g7ltt/OpenAPRS-tracker/README.md

# OpenAPRS-tracker

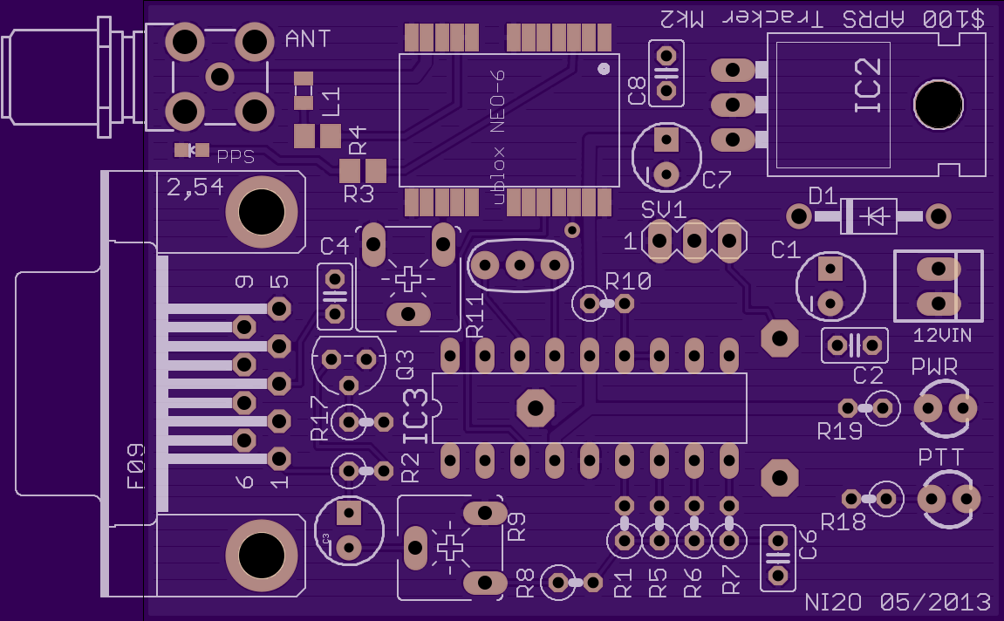
[picture p1: i.png]
opentracker
