g7ltt/OpenAPRS-tracker/AprsCirc-1a.jpg

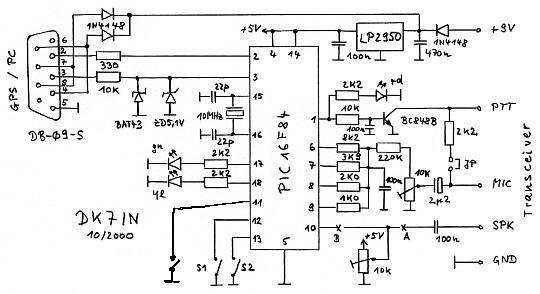
AprsCirc-1a.jpg
