g7ltt/OpenAPRS-tracker/APRSTracker_GPS.pdf

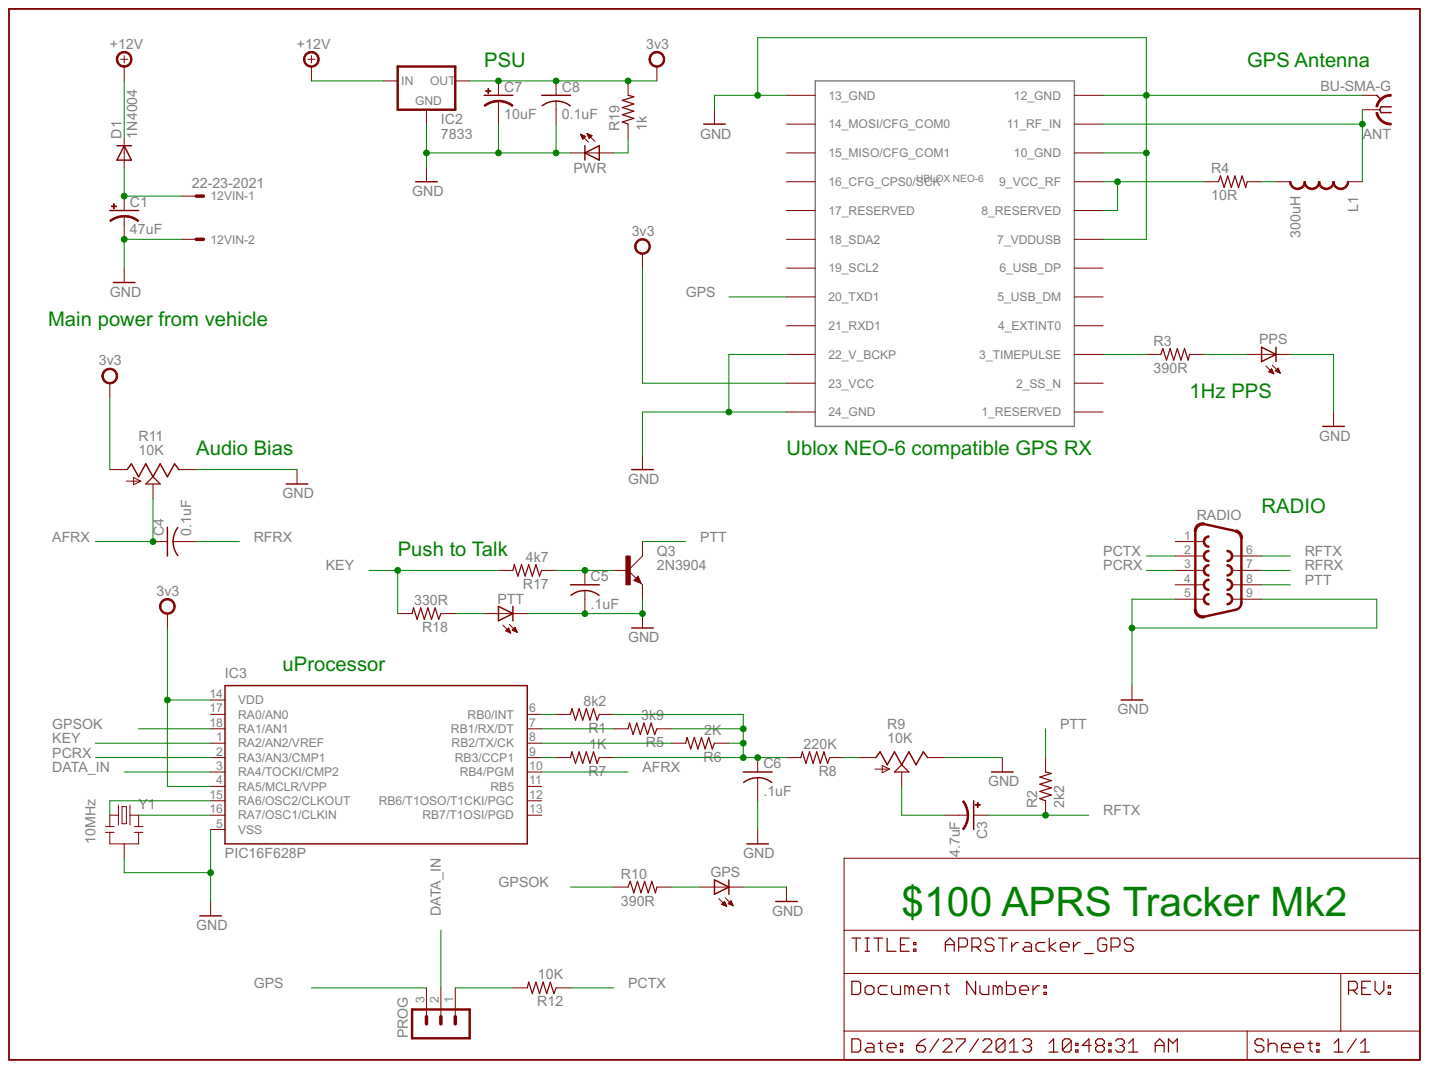
[picture p12: page 1]

Main power from vehicle

24_GND
Ublox NEO-6 compatible GPS RX
