g7ltt/OpenAPRS-tracker/APRSTracker_GPS_Mk2.pdf

Main power from vehicle

24_GND
Ublox NEO-6 compatible GPS RX
