g7ltt/OpenAPRS-tracker/OpenTracker_GPS-board.pdf

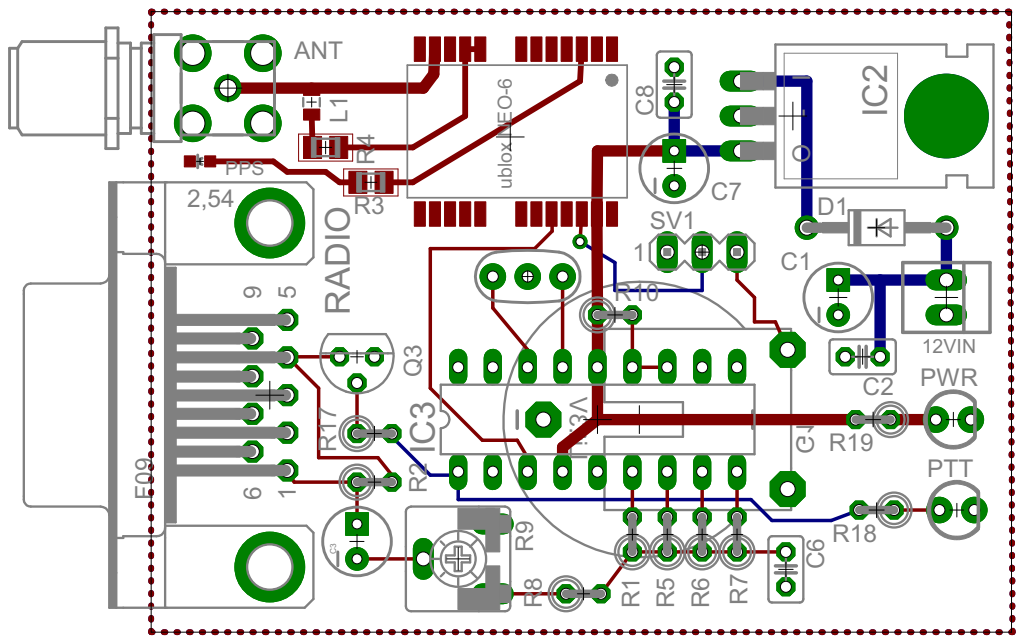
[picture p13: page 1]

G1 Lit.3V ublox NEO-6 1 95 6 2,54 F09 1 - I O ANT C2 RADIO 12VIN PPS R3 D1 R4 L1 C1 C7 C8 SV1 IC2 R2 C6 Q3 R17 R18 PTT R19 PWR IC3 R1R5R6R7 R8 R9 R10 C3
