g7ltt/OpenAPRS-tracker/OpenTracker_GPS.pdf

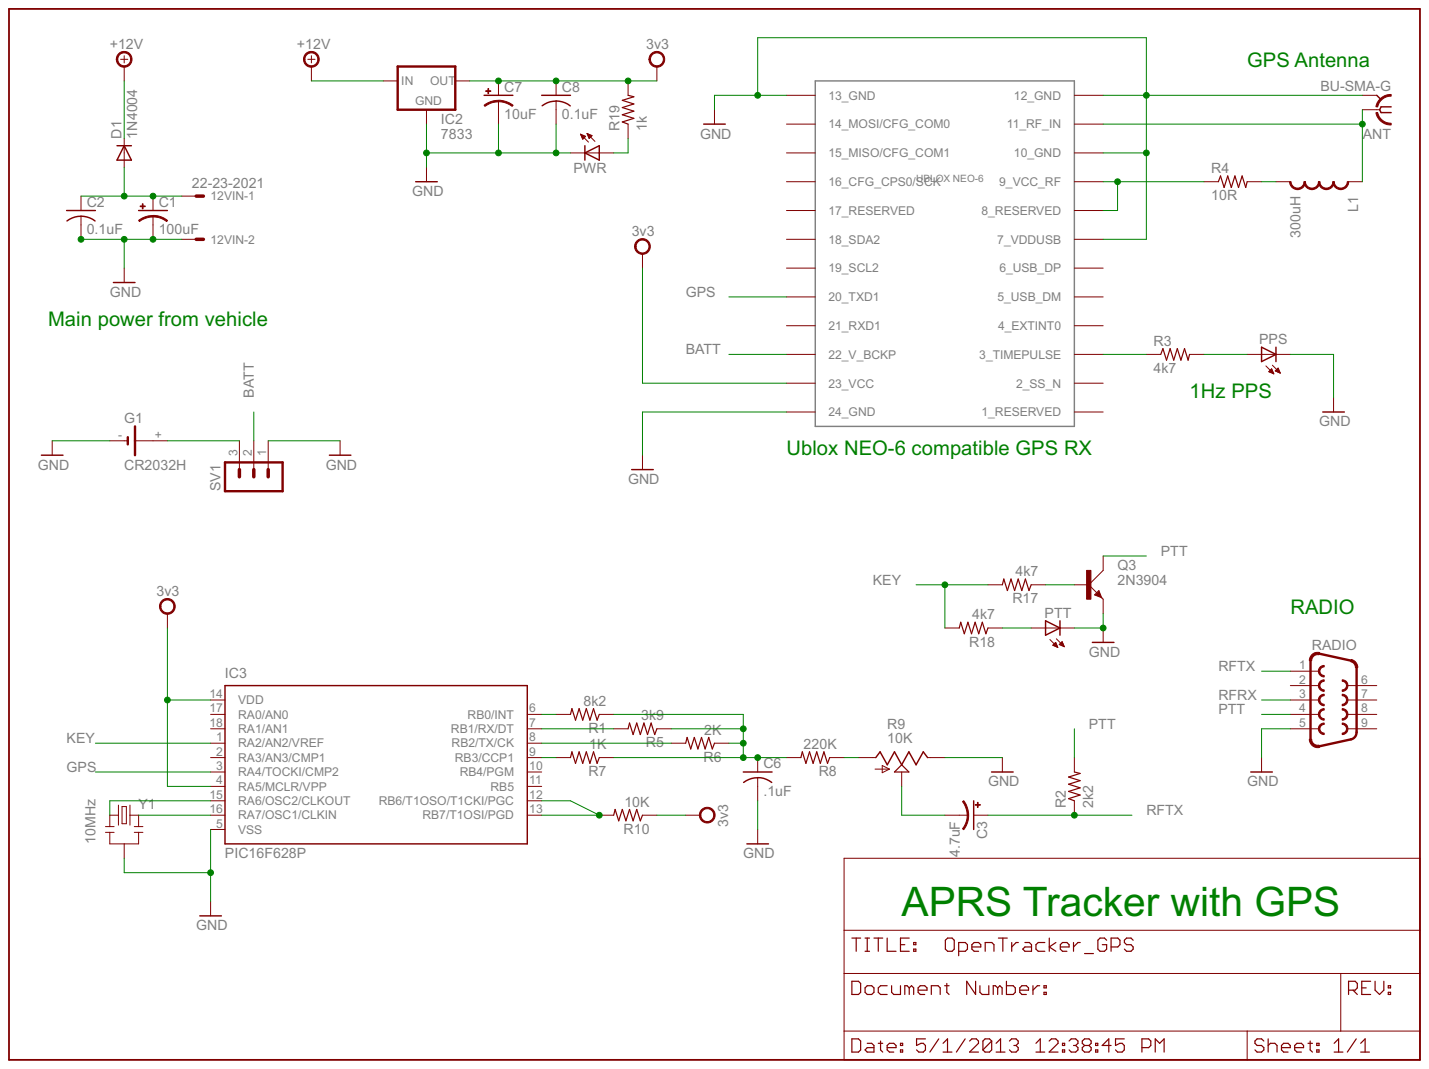
[picture p14: page 1]

Main power from vehicle

24_GND
Ublox NEO-6 compatible GPS RX

APRS Tracker with GPS
