g7ltt/OpenAPRS-tracker/APRSTracker_GPS.sch

## EAGLE design APRSTracker_GPS.sch (2021-09-01)

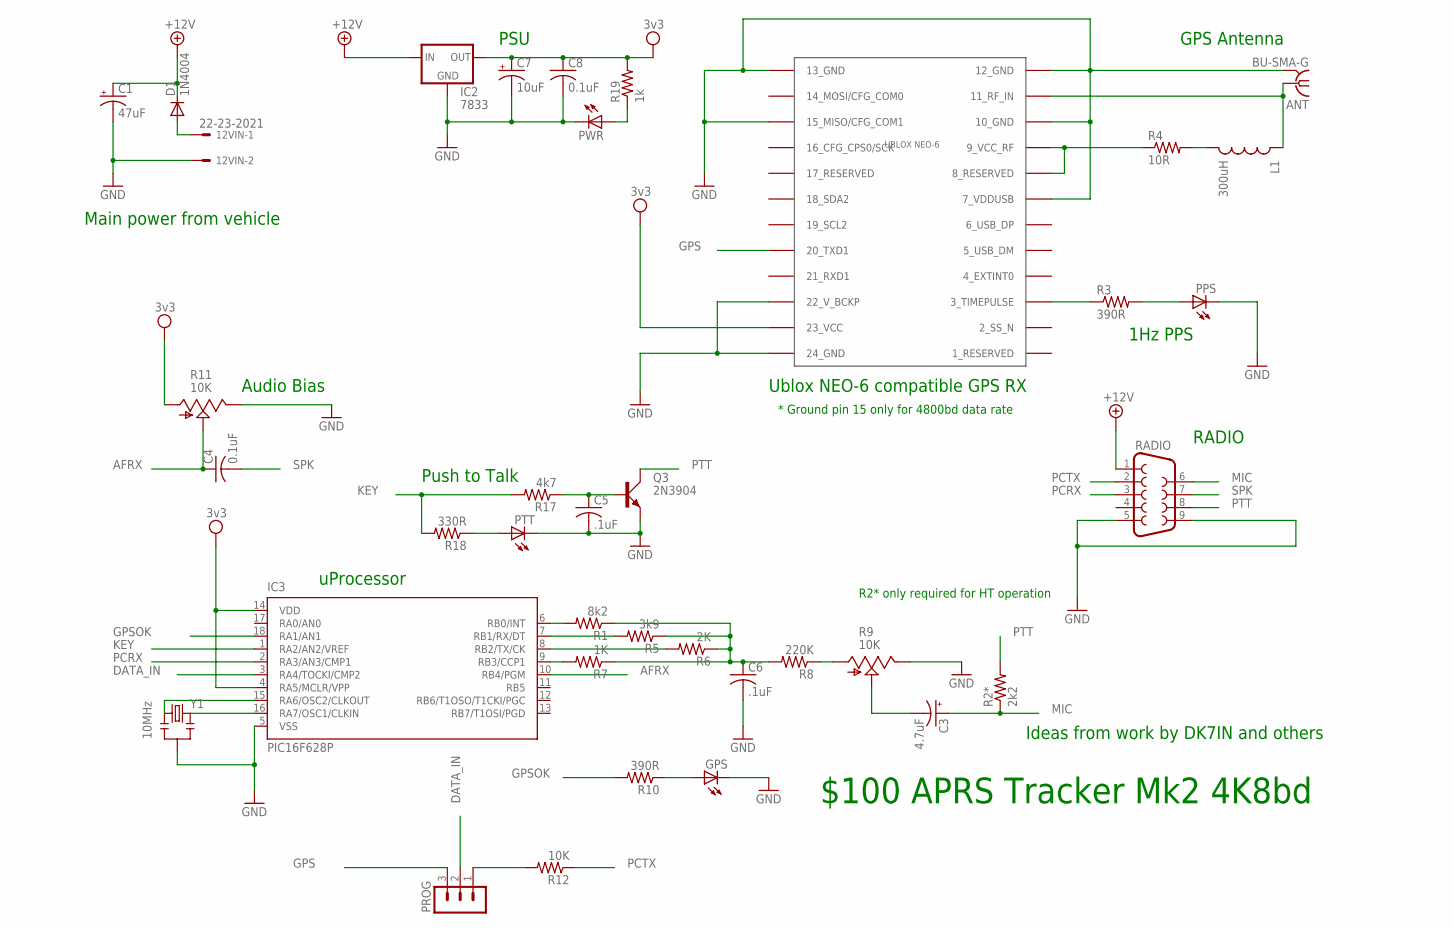
[picture p15: schematic APRSTracker_GPS.sch]

Parts:
12VIN: 22-23-2021
ANT: BU-SMA-G
C1: 47uF; CPOL-RADIAL-10UF-25V
C3: 4.7uF; CPOL-RADIAL-10UF-25V
C4, C8: 0.1uF; C025-025X050
C5, C6: .1uF; C025-025X050
C7: 10uF; CPOL-RADIAL-10UF-25V
D1: 1N4004; DO41-10
GPS: LED3MM
IC2: 7833; TO-220-ALT
IC3: PIC16F628P; DIL18
L1: 300uH; 0805
PPS: LED1206; LED-1206
PROG: MA03-1
PTT: LED3MM
PWR: LED3MM
Q3: 2N3904; TO92D
R1: 8k2; 0207/2V
R2*: 2k2; 0207/2V
R3: 390R; M0805
R4: 10R; M0805
R5: 3k9; 0207/2V
R6: 2K; 0207/2V
R7: 1K; 0207/2V
R8: 220K; 0207/2V
R9, R11: 10K; CA6V
R10: 390R; 0207/2V
R12: 10K; 0207/2V
R17: 4k7; 0207/2V
R18: 330R; 0207/2V
R19: 1k; 0207/2V
RADIO: F09HP
U$1: UBLOX_NEO-6; UBLOX_NEO-6P
Y1: 10MHz; RESONATOR-PTH

Connections:
+12V: C1.1 (+), D1.C, IC2.IN, RADIO.1
AFRX: C4.1, IC3.10 (RB4/PGM), R11.S
DATA_IN: IC3.3 (RA4/TOCKI/CMP2), PROG.2
GND: 12VIN.2, ANT.2 (GND), C1.2 (-), C5.2, C6.2, C7.2 (-), C8.2, GPS.K (C), IC2.GND, IC3.5 (VSS), PPS.C, PTT.K (C), PWR.K (C), Q3.E, R9.E, R11.E, RADIO.5, RADIO.9, U$1.7_VDDUSB, U$1.10_GND, U$1.12_GND, U$1.13_GND, U$1.15_MISO/CFG_COM1, U$1.22_V_BCKP, U$1.24_GND, Y1.2
GPS: PROG.3, U$1.20_TXD1
GPSOK: IC3.18 (RA1/AN1), R10.2
KEY: IC3.1 (RA2/AN2/VREF), R17.2, R18.2
MIC: C3.1 (+), R2*.1, RADIO.6
unnamed: R3.1, U$1.3_TIMEPULSE
unnamed: ANT.1, L1.1, U$1.11_RF_IN
unnamed: L1.2, R4.2
unnamed: R4.1, U$1.8_RESERVED, U$1.9_VCC_RF
unnamed: PPS.A, R3.2
unnamed: PWR.A, R19.1
unnamed: GPS.A, R10.1
unnamed: IC3.6 (RB0/INT), R1.2
unnamed: IC3.16 (RA7/OSC1/CLKIN), Y1.3
unnamed: IC3.15 (RA6/OSC2/CLKOUT), Y1.1
unnamed: IC3.7 (RB1/RX/DT), R5.2
unnamed: IC3.8 (RB2/TX/CK), R6.2
unnamed: IC3.9 (RB3/CCP1), R7.2
unnamed: C6.1, R1.1, R5.1, R6.1, R7.1, R8.2
unnamed: 12VIN.1, D1.A
unnamed: C3.2 (-), R9.S
unnamed: R8.1, R9.A
unnamed: PROG.1, R12.2
unnamed: C5.1, Q3.B, R17.1
unnamed: PTT.A, R18.1
PCRX: IC3.2 (RA3/AN3/CMP1), RADIO.3
PCTX: R12.1, RADIO.2
PTT: Q3.C, R2*.2, RADIO.8
SPK: C4.2, RADIO.7
VDD: C7.1 (+), C8.1, IC2.OUT, IC3.4 (RA5/MCLR/VPP), IC3.14 (VDD), R11.A, R19.2, U$1.23_VCC

Notes on the sheet:
$100 APRS Tracker Mk2 4K8bd
Main power from vehicle
Ublox NEO-6 compatible GPS RX
GPS Antenna
1Hz PPS
RADIO
Audio Bias
Push to Talk
uProcessor
PSU
R2* only required for HT operation
Ideas from work by DK7IN and others
* Ground pin 15 only for 4800bd data rate
