g7ltt/OpenAPRS-tracker/AVR_GPS_APRS_Tracker.sch

## EAGLE design AVR_GPS_APRS_Tracker.sch (2021-09-01)

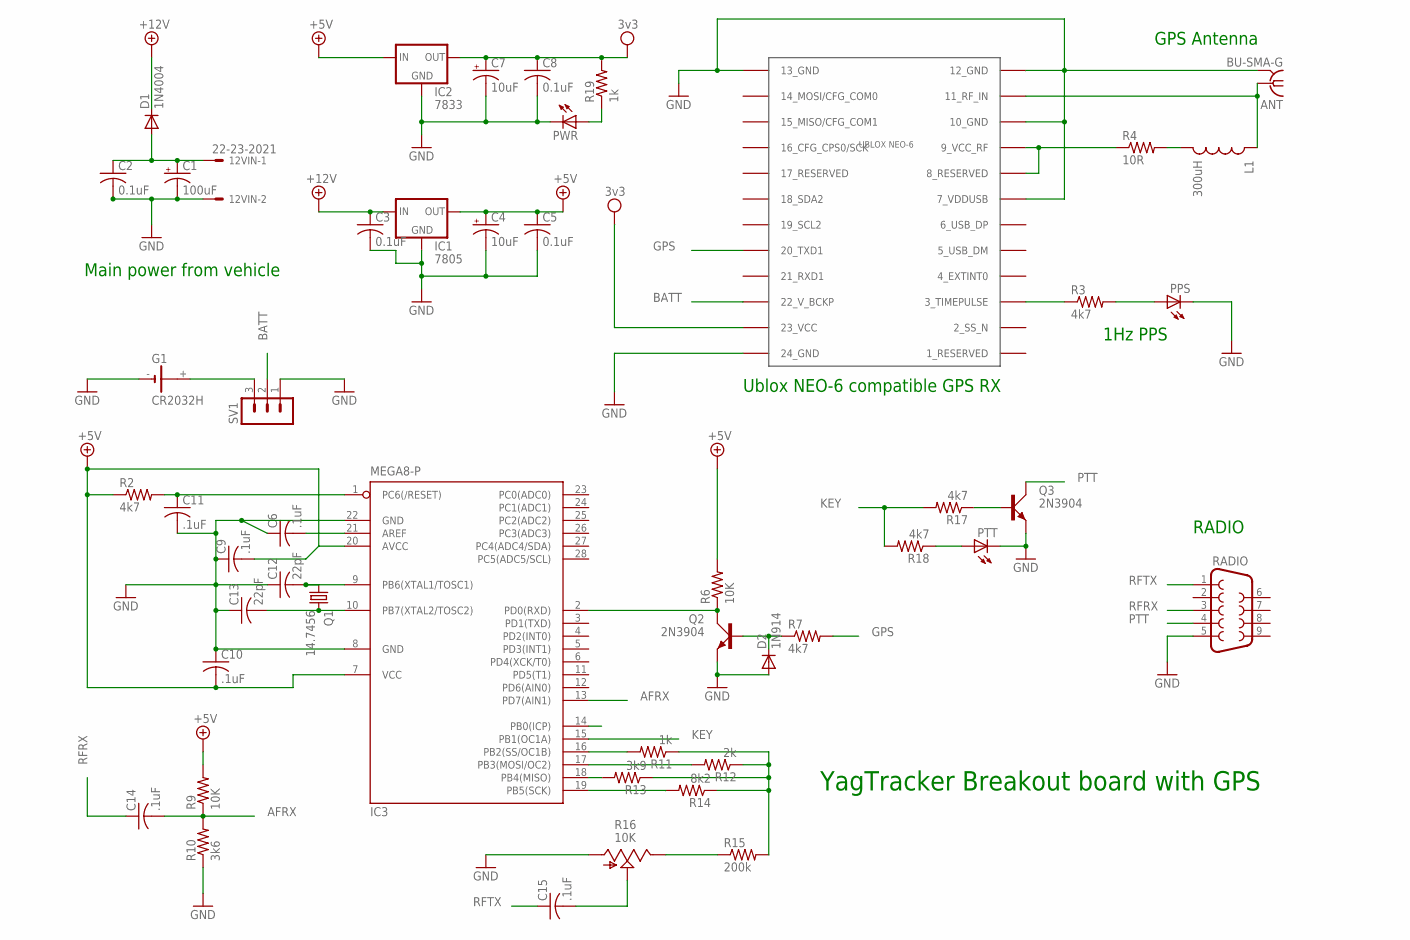
[picture p16: schematic AVR_GPS_APRS_Tracker.sch]

Parts:
12VIN: 22-23-2021
ANT: BU-SMA-G
C1: 100uF; CPOL-RADIAL-10UF-25V
C2, C3, C5, C8: 0.1uF; C025-025X050
C4, C7: 10uF; CPOL-RADIAL-10UF-25V
C6, C9, C10, C11, C14, C15: .1uF; C025-025X050
C12, C13: 22pF; C025-025X050
D1: 1N4004; DO41-10
D2: 1N914; D-2.5
G1: CR2032H
IC1: 7805; TO-220-ALT
IC2: 7833; TO-220-ALT
IC3: MEGA8-P; DIL28-3
L1: 300uH; 0805
PPS: LED0603; LED-0603
PTT: LED3MM
PWR: LED3MM
Q1: 14.7456; HC49/S
Q2, Q3: 2N3904; TO92D
R2, R7, R17, R18: 4k7; 0207/2V
R3: 4k7; M0805
R4: 10R; M0805
R6, R9: 10K; 0207/2V
R10: 3k6; 0207/2V
R11, R19: 1k; 0207/2V
R12: 2k; 0207/2V
R13: 3k9; 0207/2V
R14: 8k2; 0207/2V
R15: 200k; 0207/2V
R16: 10K; CA6V
RADIO: F09HP
SV1: MA03-1
U$1: UBLOX_NEO-6; UBLOX_NEO-6P

Connections:
+5V: C4.1 (+), C5.1, C9.2, C10.2, IC1.OUT, IC2.IN, IC3.7 (VCC), IC3.20 (AVCC), R2.1, R6.2, R9.2
+12V: C3.1, D1.C, IC1.IN
AFRX: C14.2, IC3.13 (PD7(AIN1)), R9.1, R10.2
BATT: SV1.2, U$1.22_V_BCKP
GND: 12VIN.2, ANT.2 (GND), C1.2 (-), C2.2, C3.2, C4.2 (-), C5.2, C6.1, C7.2 (-), C8.2, C9.1, C10.1, C11.2, C12.1, C13.1, D2.A, G1.-, IC1.GND, IC2.GND, IC3.8 (GND), IC3.22 (GND), PPS.C, PTT.K (C), PWR.K (C), Q2.E, Q3.E, R10.1, R16.A, RADIO.5, SV1.1, U$1.7_VDDUSB, U$1.10_GND, U$1.12_GND, U$1.13_GND, U$1.24_GND
GPS: R7.2, U$1.20_TXD1
KEY: IC3.15 (PB1(OC1A)), R17.2, R18.2
unnamed: R3.1, U$1.3_TIMEPULSE
unnamed: ANT.1, L1.1, U$1.11_RF_IN
unnamed: L1.2, R4.2
unnamed: R4.1, U$1.8_RESERVED, U$1.9_VCC_RF
unnamed: PPS.A, R3.2
unnamed: PWR.A, R19.1
unnamed: G1.+, SV1.3
unnamed: C13.2, IC3.10 (PB7(XTAL2/TOSC2)), Q1.2
unnamed: C12.2, IC3.9 (PB6(XTAL1/TOSC1)), Q1.1
unnamed: C6.2, IC3.21 (AREF)
unnamed: IC3.16 (PB2(SS/OC1B)), R11.2
unnamed: IC3.2 (PD0(RXD)), Q2.C, R6.1
unnamed: 12VIN.1, C1.1 (+), C2.1, D1.A
unnamed: D2.C, Q2.B, R7.1
unnamed: C11.1, IC3.1 (PC6(/RESET)), R2.2
unnamed: IC3.17 (PB3(MOSI/OC2)), R12.2
unnamed: IC3.18 (PB4(MISO)), R13.2
unnamed: IC3.19 (PB5(SCK)), R14.2
unnamed: R11.1, R12.1, R13.1, R14.1, R15.2
unnamed: R15.1, R16.E
unnamed: C15.2, R16.S
unnamed: Q3.B, R17.1
unnamed: PTT.A, R18.1
PTT: Q3.C, RADIO.4
RFRX: C14.1, RADIO.3
RFTX: C15.1, RADIO.1
VDD: C7.1 (+), C8.1, IC2.OUT, R19.2, U$1.23_VCC

Notes on the sheet:
YagTracker Breakout board with GPS
Main power from vehicle
Ublox NEO-6 compatible GPS RX
GPS Antenna
1Hz PPS
RADIO
